SkCubeSat/radsat-v1/README.md

# radsat-v1
Repo for RADSAT-SK OBC flight board
