SkCubeSat/radsat-v1/kicad/oresat-c3.kicad_pcb

## KiCad design kicad/oresat-c3.kicad_pcb (continued)

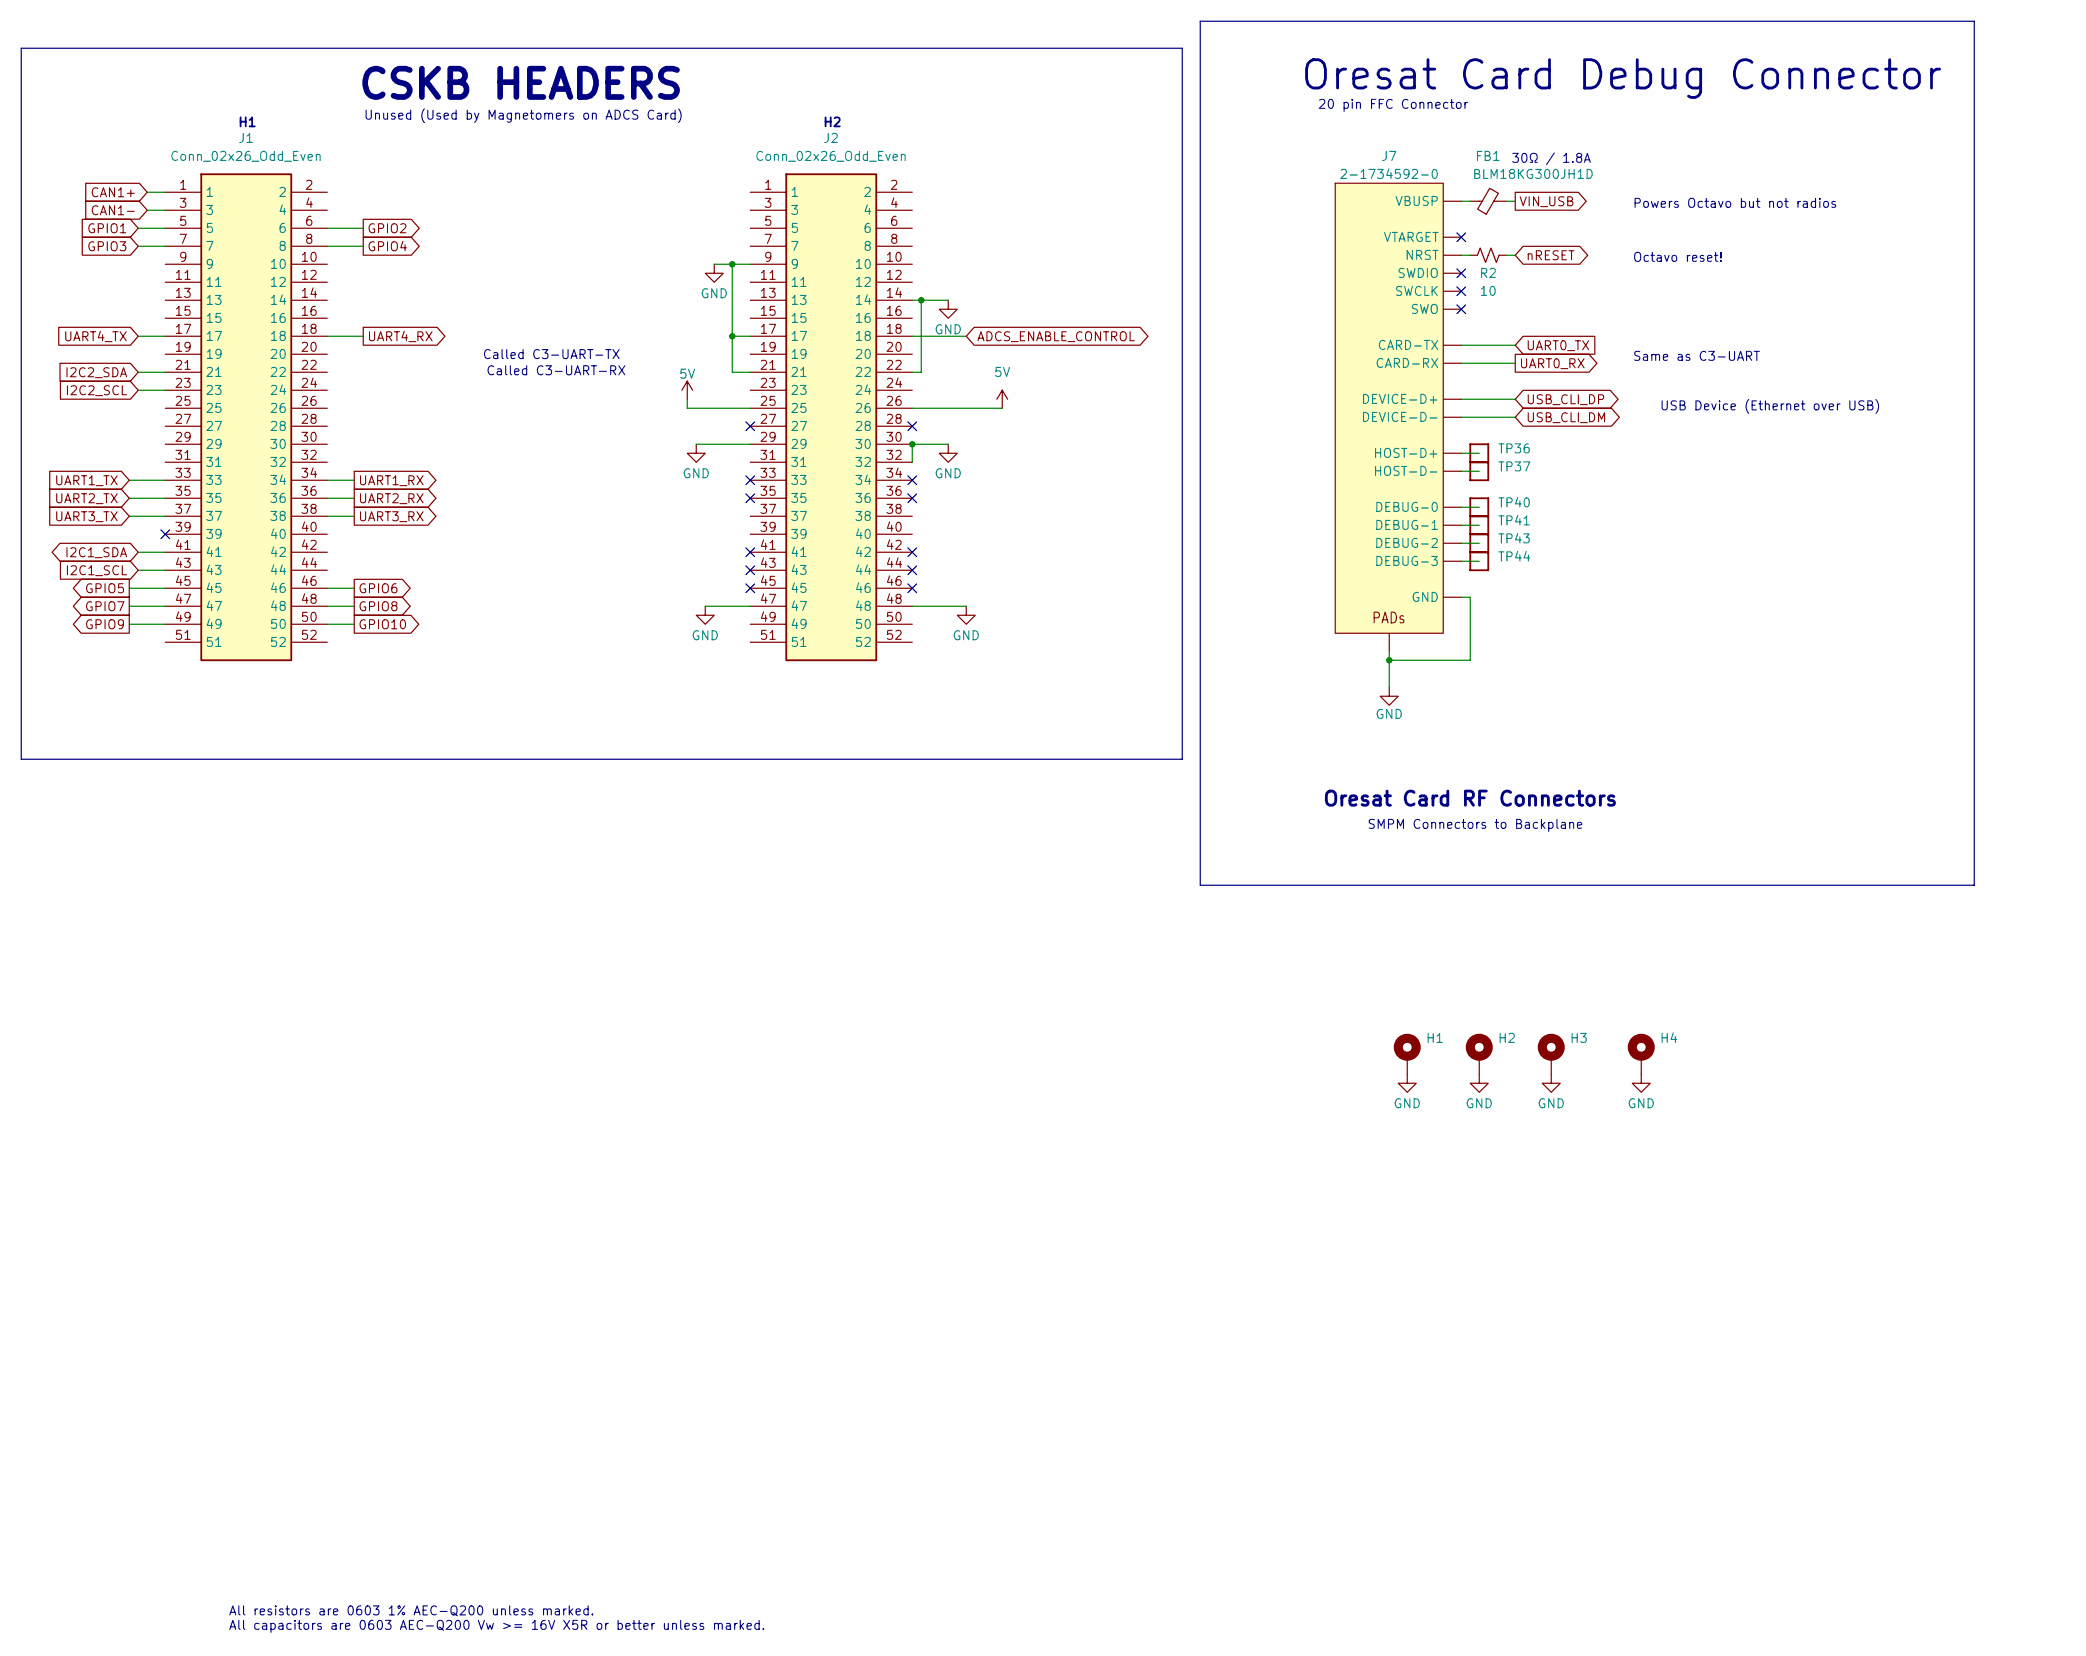
[picture p7: schematic oresat-c3-sch-connectors.kicad_sch, OreSat C3: Connectors]

Parts:
FB1: BLM18KG300JH1D; L_0603_1608Metric
H1, H2, H3, H4: MountingHole_Pad; MountingHole_3.2mm_M3_ISO7380_Pad
J1, J2: Conn_02x26_Odd_Even; RHDR52W64P254_2X26_6654X495X1135P; Manufacturer_Part_Number ESQ-126-39-G-D-001; Mouser Part Number 200-ESQ12639GD001
J7: 2-1734592-0; J-TE-2-1734592-0
R2: 10; R_0603_1608Metric
TP36, TP37, TP40, TP41, TP43, TP44: Test-Point; TestPoint_Pad_D1.0mm

Connections:
5V: J2.25, J2.26; also elsewhere on the board
ADCS_ENABLE_CONTROL: J2.18; also elsewhere on the board
CAN1+: J1.1; also elsewhere on the board
CAN1-: J1.3; also elsewhere on the board
GND: H1.1, H2.1, H3.1, H4.1, J2.9, J2.14, J2.17, J2.21, J2.22, J2.29, J2.30, J2.32, J2.47, J2.48, J7.3 (GND), J7.6 (GND), J7.9 (GND), J7.PAD1 (PAD), J7.PAD2 (PAD); also elsewhere on the board
GPIO1: J1.5
GPIO2: J1.6
GPIO3: J1.7
GPIO4: J1.8
GPIO5: J1.45
GPIO6: J1.46
GPIO7: J1.47
GPIO8: J1.48
GPIO9: J1.49
GPIO10: J1.50
I2C1_SCL: J1.43; also elsewhere on the board
I2C1_SDA: J1.41; also elsewhere on the board
I2C2_SCL: J1.23; also elsewhere on the board
I2C2_SDA: J1.21; also elsewhere on the board
unnamed: FB1.1, J7.1 (VBUSP), J7.2 (VBUSP)
unnamed: J7.17 (DEBUG-0), TP40.1
unnamed: J7.18 (DEBUG-1), TP41.1
unnamed: J7.19 (DEBUG-2), TP43.1
unnamed: J7.20 (DEBUG-3), TP44.1
unnamed: J7.7 (HOST-D+), TP36.1
unnamed: J7.8 (HOST-D-), TP37.1
unnamed: J7.10 (NRST), R2.1
UART0_RX: J7.12 (CARD-RX); also elsewhere on the board
UART0_TX: J7.13 (CARD-TX); also elsewhere on the board
UART1_RX: J1.34; also elsewhere on the board
UART1_TX: J1.33; also elsewhere on the board
UART2_RX: J1.36
UART2_TX: J1.35
UART3_RX: J1.38
UART3_TX: J1.37
UART4_RX: J1.18
UART4_TX: J1.17
USB_CLI_DM: J7.5 (DEVICE-D-); also elsewhere on the board
USB_CLI_DP: J7.4 (DEVICE-D+); also elsewhere on the board
VIN_USB: FB1.2; also elsewhere on the board
nRESET: R2.2; also elsewhere on the board

Notes on the sheet:
Powers Octavo but not radios
Called C3-UART-TX
Unused (Used by Magnetomers on ADCS Card)
USB Device (Ethernet over USB)
Oresat Card RF Connectors
Oresat Card Debug Connector
Called C3-UART-RX
Octavo reset!
CSKB HEADERS
SMPM Connectors to Backplane
30Ω / 1.8A
20 pin FFC Connector
Same as C3-UART
All resistors are 0603 1% AEC-Q200 unless marked. All capacitors are 0603 AEC-Q200 Vw >= 16V X5R or better unless marked.

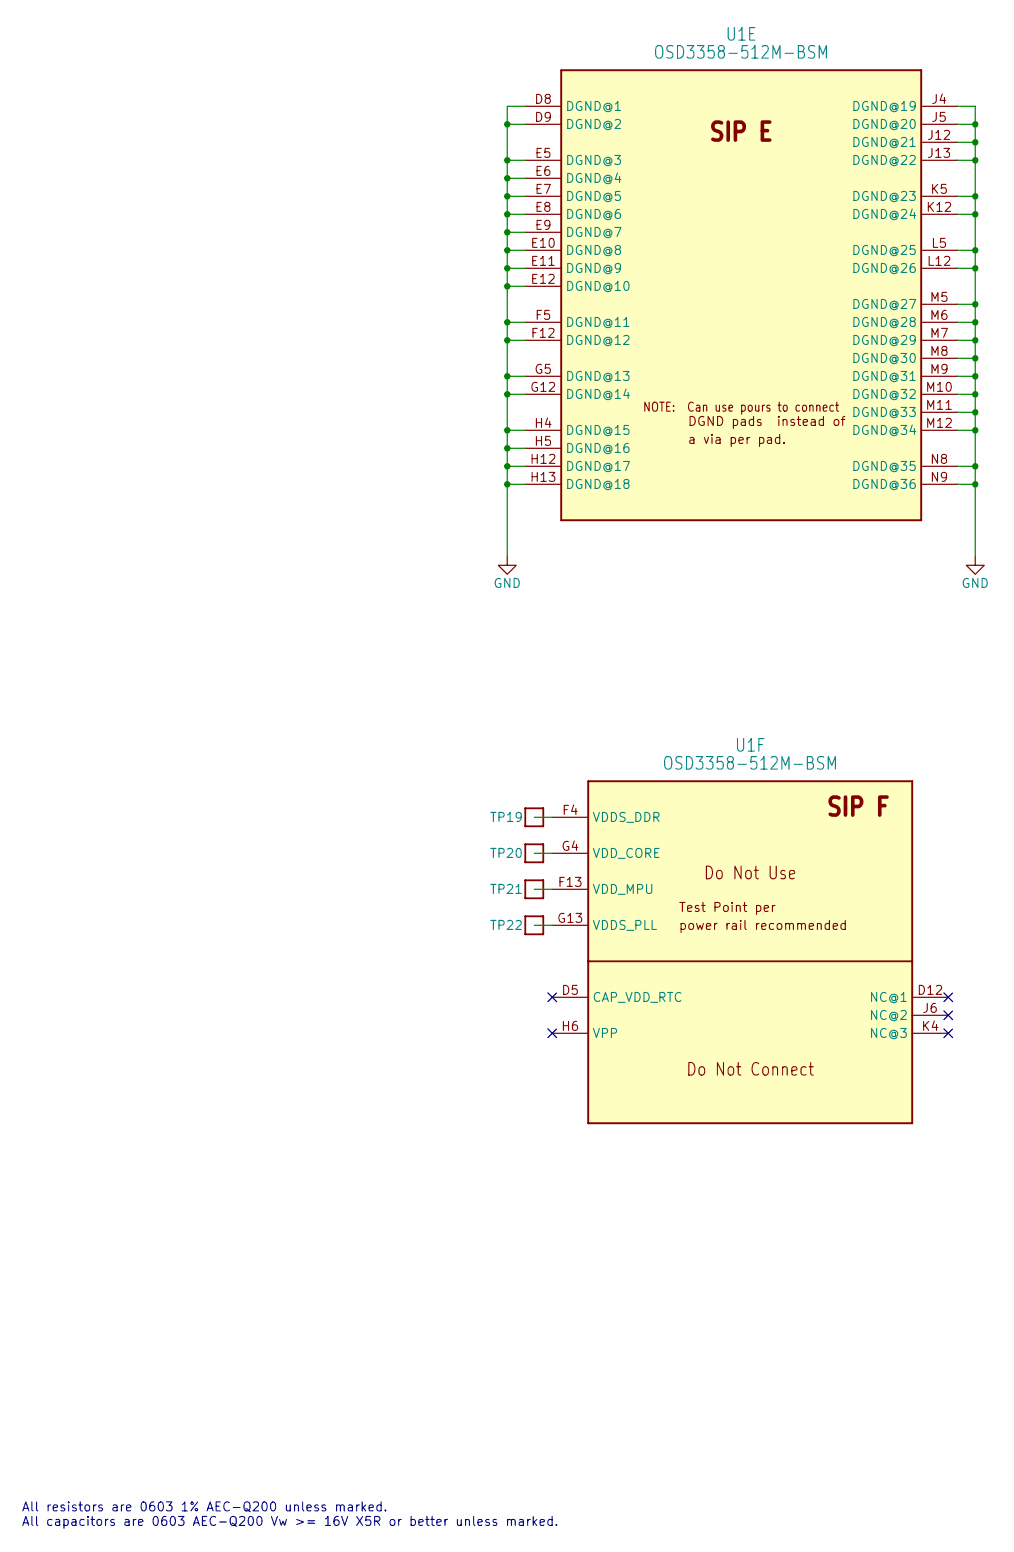
[picture p8: schematic oresat-c3-sch-osd3358-sip-e-f.kicad_sch, OreSat C3: OSD3358 SIP E + F]

Parts:
TP19, TP20, TP21, TP22: Test-Point; TestPoint_Pad_D1.0mm
U1: OSD3358-512M-BSM; U-Octavo-OSD335X-BGA-256; MPN OSD3358-512M-BSM

Connections:
GND: U1.D8 (DGND@1), U1.D9 (DGND@2), U1.E5 (DGND@3), U1.E6 (DGND@4), U1.E7 (DGND@5), U1.E8 (DGND@6), U1.E9 (DGND@7), U1.E10 (DGND@8), U1.E11 (DGND@9), U1.E12 (DGND@10), U1.F5 (DGND@11), U1.F12 (DGND@12), U1.G5 (DGND@13), U1.G12 (DGND@14), U1.H4 (DGND@15), U1.H5 (DGND@16), U1.H12 (DGND@17), U1.H13 (DGND@18), U1.J4 (DGND@19), U1.J5 (DGND@20), U1.J12 (DGND@21), U1.J13 (DGND@22), U1.K5 (DGND@23), U1.K12 (DGND@24), U1.L5 (DGND@25), U1.L12 (DGND@26), U1.M5 (DGND@27), U1.M6 (DGND@28), U1.M7 (DGND@29), U1.M8 (DGND@30), U1.M9 (DGND@31), U1.M10 (DGND@32), U1.M11 (DGND@33), U1.M12 (DGND@34), U1.N8 (DGND@35), U1.N9 (DGND@36); also elsewhere on the board
unnamed: TP19.1, U1.F4 (VDDS_DDR)
unnamed: TP22.1, U1.G13 (VDDS_PLL)
unnamed: TP20.1, U1.G4 (VDD_CORE)
unnamed: TP21.1, U1.F13 (VDD_MPU)

Notes on the sheet:
All resistors are 0603 1% AEC-Q200 unless marked. All capacitors are 0603 AEC-Q200 Vw >= 16V X5R or better unless marked.

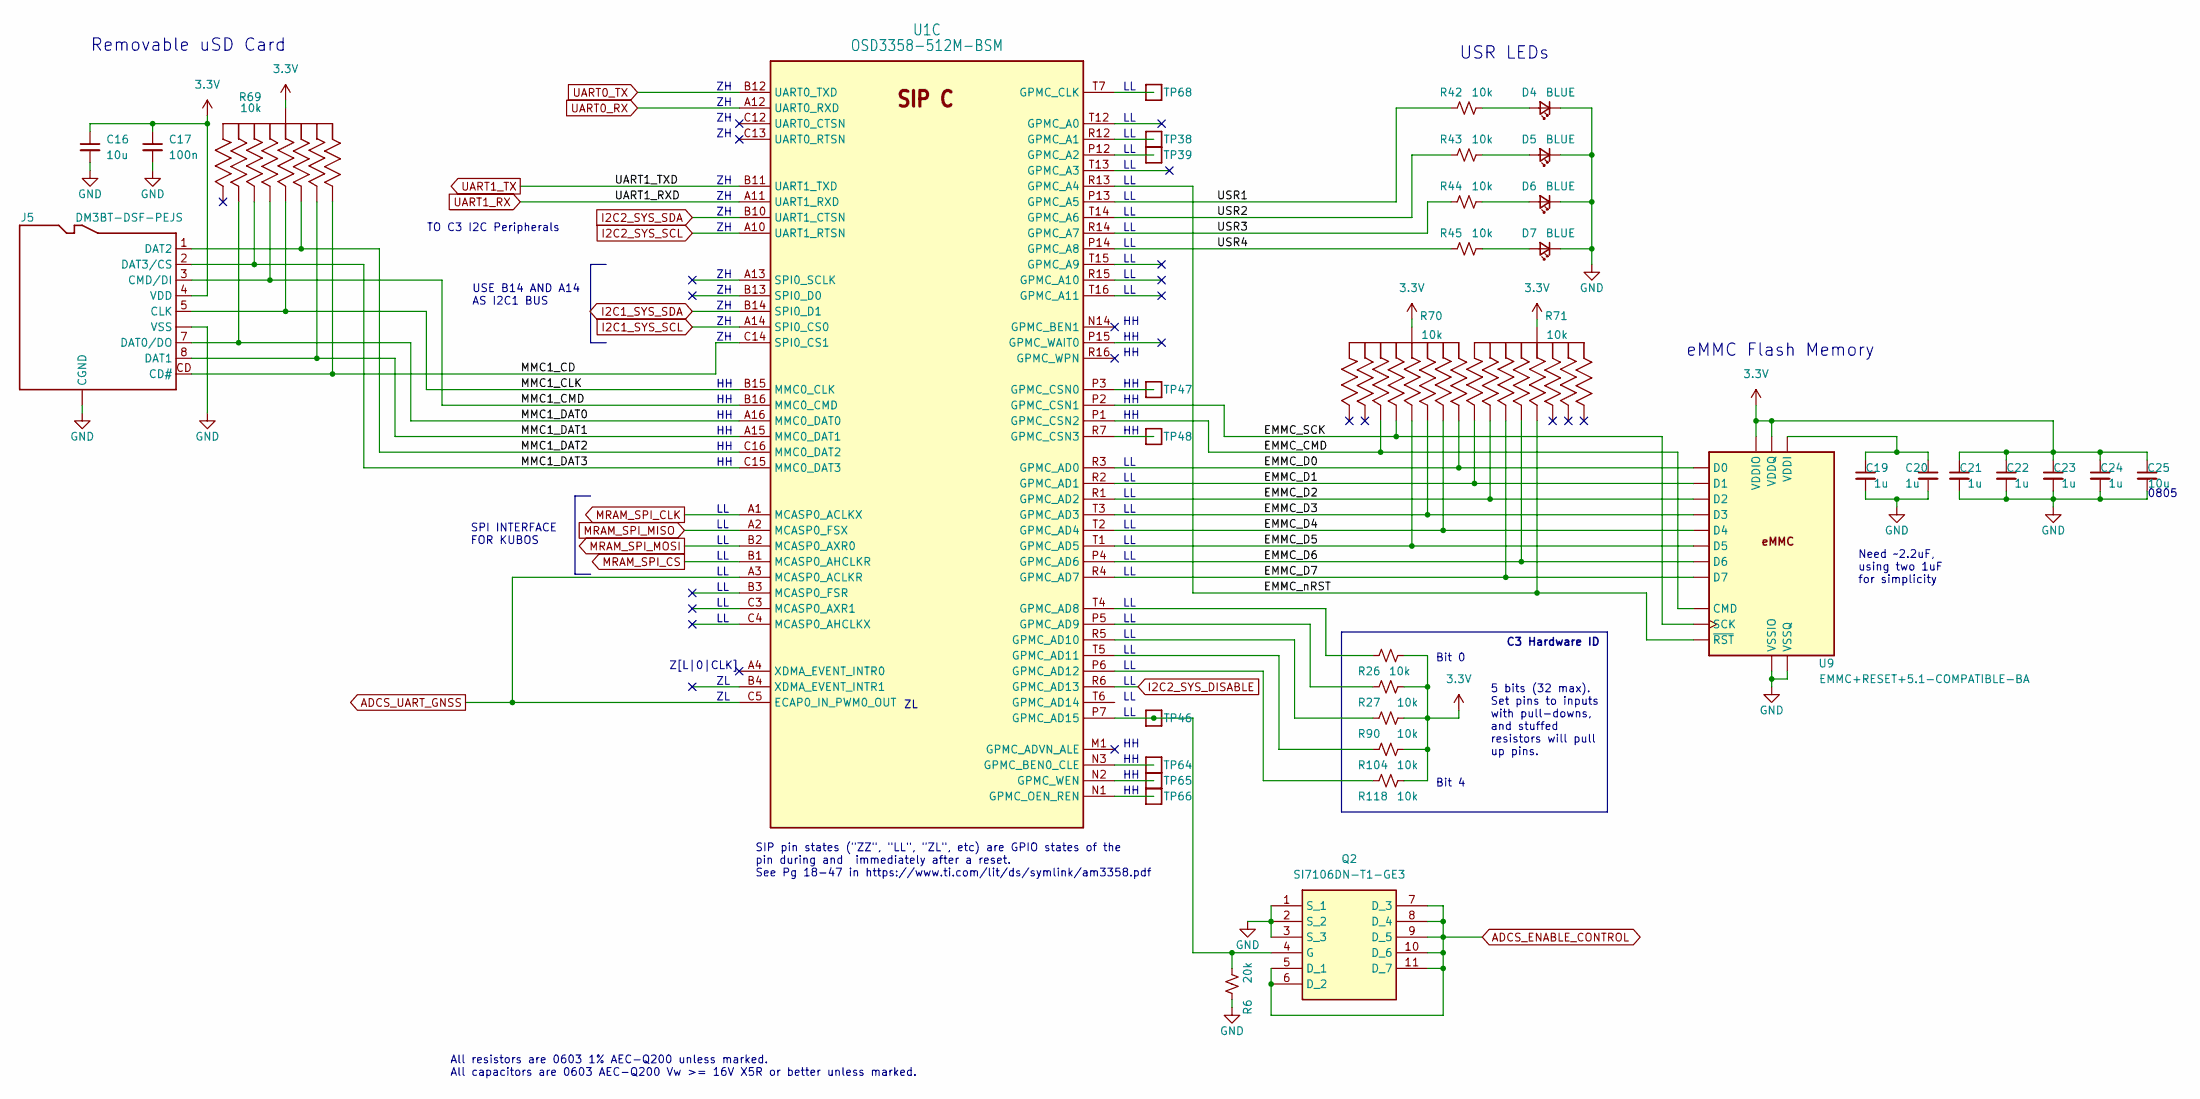
[picture p9: schematic oresat-c3-sch-osd3358-sd-emmc.kicad_sch, OreSat C3: OSD3358 SIP C]

Parts:
C16, C25: 10u; C_0805_2012Metric
C17: 100n; C_0603_1608Metric
C19, C20, C21, C22, C23, C24: 1u; C_0603_1608Metric
D4, D5, D6, D7: BLUE; LED_0603_1608Metric
J5: DM3BT-DSF-PEJS; J-Hirose-DM3BT-DSF-PEJS
Q2: SI7106DN-T1-GE3; SIS862DNT1GE3; Mouser Part Number 781-SI7106DN-T1-GE3
R6: 20k; R_0603_1608Metric
R26, R27, R42, R43, R44, R45, R90, R104, R118: 10k; R_0603_1608Metric
R69, R70, R71: 10k; Panasonic_Resistor_Array_EXBA10
TP38, TP39, TP46, TP47, TP48, TP64, TP65, TP66, TP68: Test-Point; TestPoint_Pad_D1.0mm
U1: OSD3358-512M-BSM; U-Octavo-OSD335X-BGA-256; MPN OSD3358-512M-BSM
U9: EMMC+RESET+5.1-COMPATIBLE-BA; BGA-153(11.5X13)(EMMC-BA)

Connections:
3.3V: C16.1, C17.1, C21.1, C22.1, C23.1, C24.1, C25.1, J5.4 (VDD), R26.1, R27.1, R69.5 (55), R69.10 (55), R70.5 (55), R70.10 (55), R71.5 (55), R71.10 (55), R90.1, R104.1, R118.1, U9.C6 (VDDQ), U9.E6 (VDDIO), U9.F5 (VDDIO), U9.J10 (VDDIO), U9.K9 (VDDIO), U9.M4 (VDDQ), U9.N4 (VDDQ), U9.P3 (VDDQ), U9.P5 (VDDQ); also elsewhere on the board
/OSD3358: SIP C/EMMC_CMD: R70.2 (22), U1.P1 (GPMC_CSN2), U9.M5 (CMD)
/OSD3358: SIP C/EMMC_D0: R70.6 (66), U1.R3 (GPMC_AD0), U9.A3 (D0)
/OSD3358: SIP C/EMMC_D1: R71.1 (11), U1.R2 (GPMC_AD1), U9.A4 (D1)
/OSD3358: SIP C/EMMC_D2: R71.9 (99), U1.R1 (GPMC_AD2), U9.A5 (D2)
/OSD3358: SIP C/EMMC_D3: R70.7 (77), U1.T3 (GPMC_AD3), U9.B2 (D3)
/OSD3358: SIP C/EMMC_D4: R70.4 (44), U1.T2 (GPMC_AD4), U9.B3 (D4)
/OSD3358: SIP C/EMMC_D5: R70.3 (33), U1.T1 (GPMC_AD5), U9.B4 (D5)
/OSD3358: SIP C/EMMC_D6: R71.8 (88), U1.P4 (GPMC_AD6), U9.B5 (D6)
/OSD3358: SIP C/EMMC_D7: R71.2 (22), U1.R4 (GPMC_AD7), U9.B6 (D7)
/OSD3358: SIP C/EMMC_SCK: R70.8 (88), U1.P2 (GPMC_CSN1), U9.M6 (SCK)
/OSD3358: SIP C/EMMC_nRST: R71.3 (33), U1.R13 (GPMC_A4), U9.K5 (~RST)
/OSD3358: SIP C/MMC1_CD: J5.CD (CD#), R69.6 (66), U1.C14 (SPI0_CS1)
/OSD3358: SIP C/MMC1_CLK: J5.5 (CLK), R69.3 (33), U1.B15 (MMC0_CLK)
/OSD3358: SIP C/MMC1_CMD: J5.3 (CMD/DI), R69.8 (88), U1.B16 (MMC0_CMD)
/OSD3358: SIP C/MMC1_DAT0: J5.7 (DAT0/DO), R69.9 (99), U1.A16 (MMC0_DAT0)
/OSD3358: SIP C/MMC1_DAT1: J5.8 (DAT1), R69.4 (44), U1.A15 (MMC0_DAT1)
/OSD3358: SIP C/MMC1_DAT2: J5.1 (DAT2), R69.7 (77), U1.C16 (MMC0_DAT2)
/OSD3358: SIP C/MMC1_DAT3: J5.2 (DAT3/CS), R69.2 (22), U1.C15 (MMC0_DAT3)
/OSD3358: SIP C/USR1: R42.1, U1.P13 (GPMC_A5)
/OSD3358: SIP C/USR2: R43.1, U1.T14 (GPMC_A6)
/OSD3358: SIP C/USR3: R44.1, U1.R14 (GPMC_A7)
/OSD3358: SIP C/USR4: R45.1, U1.P14 (GPMC_A8)
ADCS_ENABLE_CONTROL: Q2.5 (D_1), Q2.6 (D_2), Q2.7 (D_3), Q2.8 (D_4), Q2.9 (D_5), Q2.10 (D_6), Q2.11 (D_7); also elsewhere on the board
ADCS_UART_GNSS: U1.A3 (MCASP0_ACLKR), U1.C5 (ECAP0_IN_PWM0_OUT)
GND: C16.2, C17.2, C19.2, C20.2, C21.2, C22.2, C23.2, C24.2, C25.2, D4.1 (K), D5.1 (K), D6.1 (K), D7.1 (K), J5.6 (VSS), J5.CGND1 (CGND), J5.CGND2 (CGND), J5.CGND3 (CGND), J5.CGND4 (CGND), J5.CGND5 (CGND), J5.CGND6 (CGND), J5.GND (VSS), Q2.1 (S_1), Q2.2 (S_2), Q2.3 (S_3), R6.2, U9.A2 (NC), U9.A6 (VSSIO), U9.B7 (NC), U9.C4 (VSSQ), U9.E7 (VSSIO), U9.G5 (VSSIO), U9.H10 (VSSIO), U9.J5 (VSSIO), U9.K8 (VSSIO), U9.N2 (VSSQ), U9.N5 (VSSQ), U9.P4 (VSSQ), U9.P6 (VSSQ); also elsewhere on the board
I2C1_SYS_SCL: U1.A14 (SPI0_CS0); also elsewhere on the board
I2C1_SYS_SDA: U1.B14 (SPI0_D1); also elsewhere on the board
I2C2_SYS_DISABLE: U1.R6 (GPMC_AD13); also elsewhere on the board
I2C2_SYS_SCL: U1.A10 (UART1_RTSN); also elsewhere on the board
I2C2_SYS_SDA: U1.B10 (UART1_CTSN); also elsewhere on the board
MRAM_SPI_CLK: U1.A1 (MCASP0_ACLKX); also elsewhere on the board
MRAM_SPI_CS: U1.B1 (MCASP0_AHCLKR); also elsewhere on the board
MRAM_SPI_MISO: U1.A2 (MCASP0_FSX); also elsewhere on the board
MRAM_SPI_MOSI: U1.B2 (MCASP0_AXR0); also elsewhere on the board
unnamed: D4.2 (A), R42.2
unnamed: D5.2 (A), R43.2
unnamed: D6.2 (A), R44.2
unnamed: D7.2 (A), R45.2
unnamed: Q2.4 (G), R6.1, TP46.1, U1.P7 (GPMC_AD15)
unnamed: TP38.1, U1.R12 (GPMC_A1)
unnamed: TP39.1, U1.P12 (GPMC_A2)
unnamed: R26.2, U1.T4 (GPMC_AD8)
unnamed: R27.2, U1.P5 (GPMC_AD9)
unnamed: R90.2, U1.R5 (GPMC_AD10)
unnamed: R104.2, U1.T5 (GPMC_AD11)
unnamed: R118.2, U1.P6 (GPMC_AD12)
unnamed: TP64.1, U1.N3 (GPMC_BEN0_CLE)
unnamed: TP68.1, U1.T7 (GPMC_CLK)
unnamed: TP47.1, U1.P3 (GPMC_CSN0)
unnamed: TP48.1, U1.R7 (GPMC_CSN3)
unnamed: TP66.1, U1.N1 (GPMC_OEN_REN)
unnamed: TP65.1, U1.N2 (GPMC_WEN)
unnamed: C19.1, C20.1, U9.C2 (VDDI)
UART0_RX: U1.A12 (UART0_RXD); also elsewhere on the board
UART0_TX: U1.B12 (UART0_TXD); also elsewhere on the board
UART1_RX: U1.A11 (UART1_RXD); also elsewhere on the board
UART1_TX: U1.B11 (UART1_TXD); also elsewhere on the board

Notes on the sheet:
0805
5 bits (32 max). Set pins to inputs with pull-downs, and stuffed resistors will pull up pins.
eMMC Flash Memory
SPI INTERFACE FOR KUBOS
Removable uSD Card
C3 Hardware ID
Need ~2.2uF, using two 1uF for simplicity
Bit 0
SIP pin states ("ZZ", "LL", "ZL", etc) are GPIO states of the pin during and immediately after a reset. See Pg 18-47 in https://www.ti.com/lit/ds/symlink/am3358.pdf
USR LEDs
Z[L|0|CLK]
Bit 4
TO C3 I2C Peripherals
All resistors are 0603 1% AEC-Q200 unless marked. All capacitors are 0603 AEC-Q200 Vw >= 16V X5R or better unless marked.
USE B14 AND A14 AS I2C1 BUS

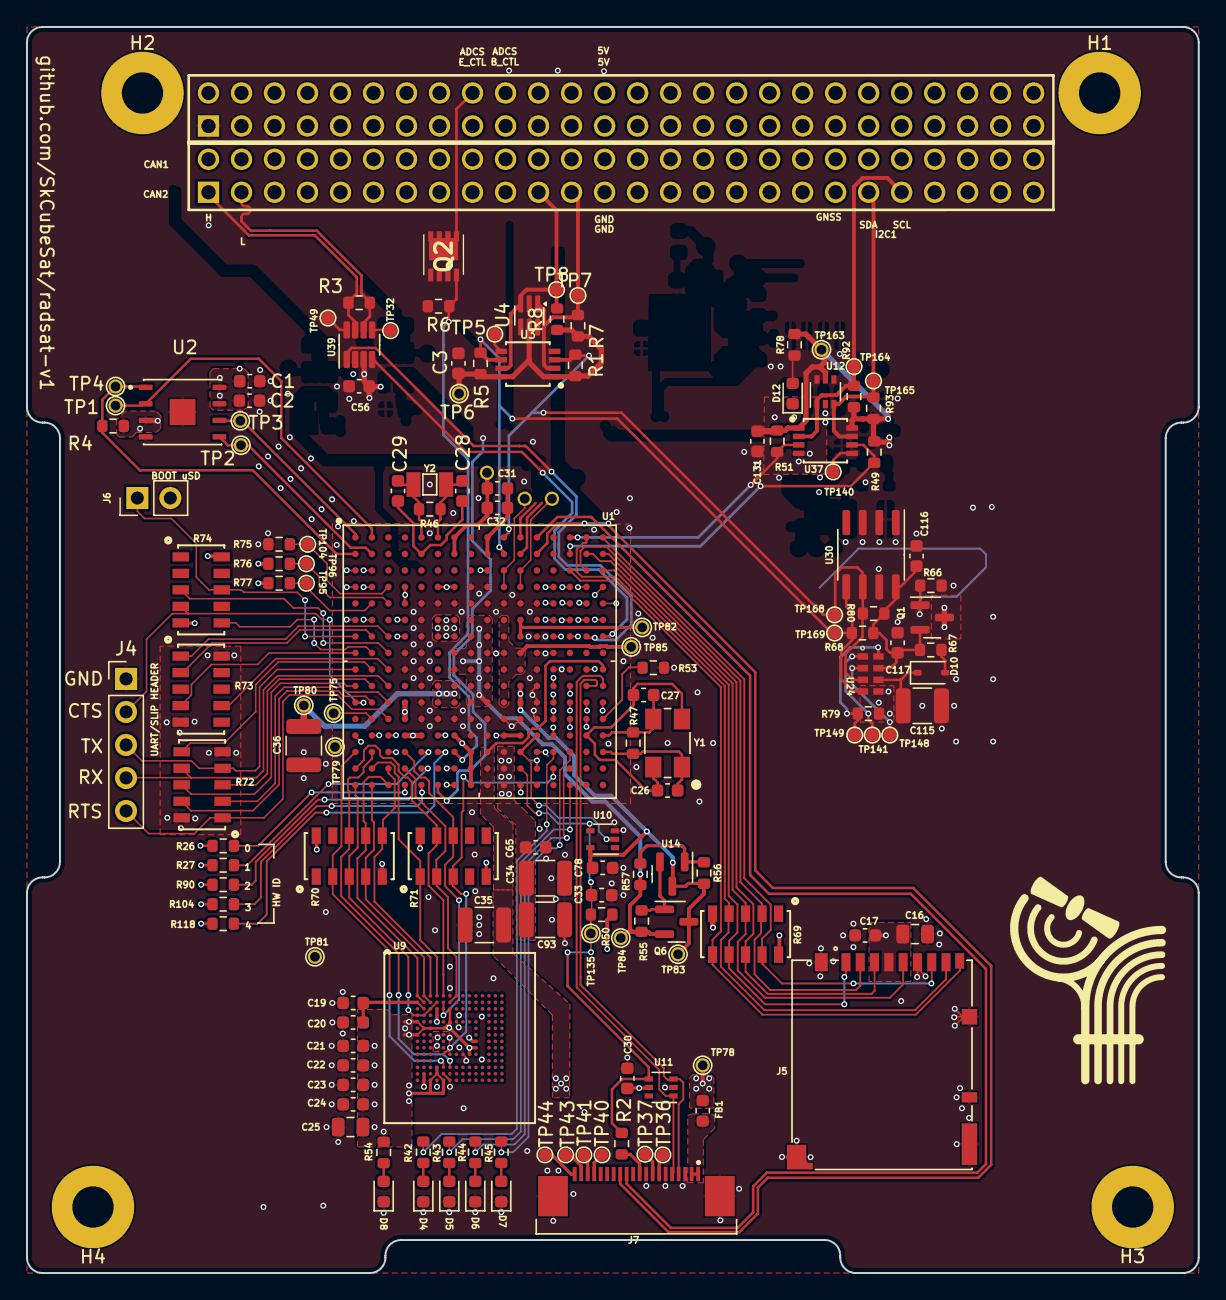
[picture p10: board oresat-c3.kicad_pcb from above]

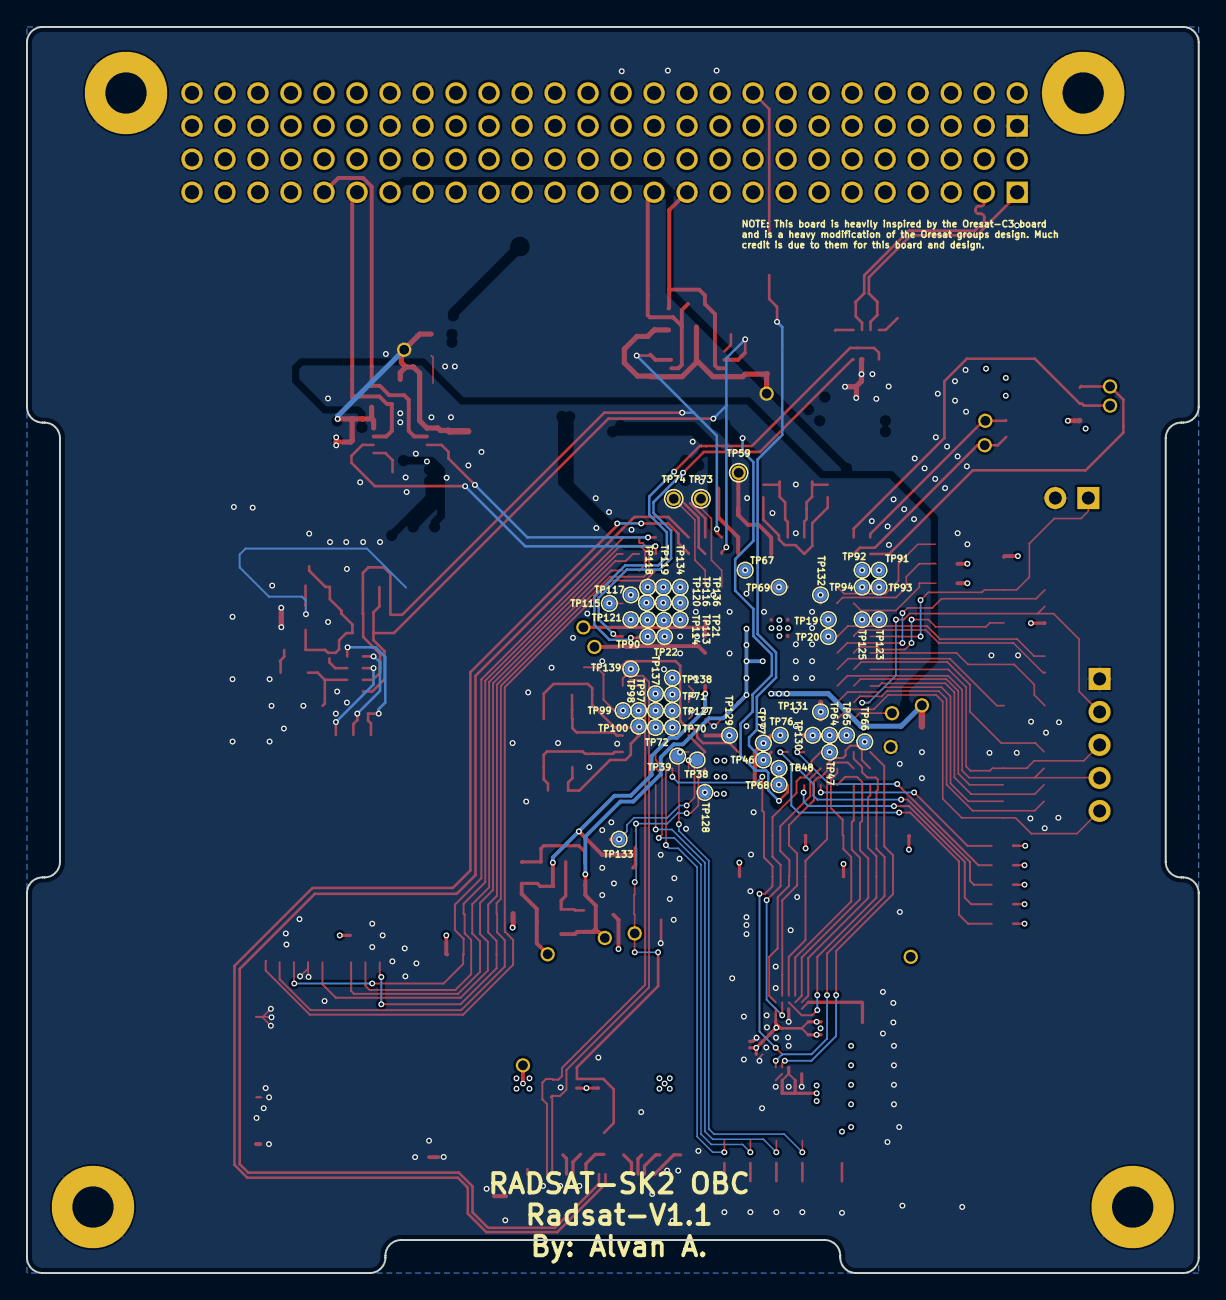
[picture p11: board oresat-c3.kicad_pcb from below]

Board: 4 copper layers, 90.2 x 95.9 mm, 204 parts (55 on the bottom side), 172 nets.

Other parts of the board:
C3: 10n; C_0603_1608Metric
R1, R5, R7, R8: 10k; R_0603_1608Metric
TP5: TestPoint_Pad_D1.0mm
TP6: TestPoint-MinTH; TestPoint-0.75mm-th
TP7, TP8: Test-Point; TestPoint_Pad_D1.0mm
U3: LTC4300A-1; LINEAR-MSOP-8-AND-MAXIM-UMAX-8-21-0036
U4: RCLAMP0504FB; SOT-363_SC-70-6

Their connections:
3.3V: C3.1, R1.1, R5.1, R7.1, R8.1, TP6.1, U3.1 (ENABLE), U3.8 (VCC), U4.5 (VCC); also elsewhere on the board
GND: C3.2, U3.4 (GND), U4.2 (GND); also elsewhere on the board
I2C2_SCL: R7.2, TP7.1, U3.2 (SCLOUT), U4.1 (I1); also elsewhere on the board
I2C2_SDA: R8.2, TP8.1, U3.7 (SDAOUT), U4.3 (I2); also elsewhere on the board
I2C2_SYS_SCL: R1.2, U3.3 (SCLIN); also elsewhere on the board
I2C2_SYS_SDA: R5.2, U3.6 (SDAIN); also elsewhere on the board
unnamed: TP5.1, U3.5 (READY)
