SkCubeSat/radsat-v1/(commit log)

2024-02-16 Initial commit with oresat OBC kicad files
    [oresat-c3-sch-connectors.kicad_sch, oresat-c3-sch-deployers.kicad_sch, oresat-c3-sch-i2c-peripherals.kicad_sch, oresat-c3-sch-l-band.kicad_sch, oresat-c3-sch-opd-and-i2c.kicad_sch, oresat-c3-sch-osd3358-power.kicad_sch, oresat-c3-sch-osd3358-sd-emmc.kicad_sch, oresat-c3-sch-osd3358-sip-e-f.kicad_sch]
2024-02-19 Added Oresat symbol lib. Removed any L-band related components from pcb and schematic
    [J-Amphenol-132134-10-SMA-F-SMT-vertical.stp, J-Harwin-M80-5100442.stp, J-Molex-547220304.stp, J-Molex-555600307.stp, J-Molex-SMPM-733000020.stp, J-SAMTEC-TFM-110-01-L-D-RA.stp, J-SAMTEC-TFM-120-01-L-D-RA.stp, J-TE-2-1734592-0-c-3d.stp]
2024-02-19 Removed UF band
    [oresat-c3-sch-connectors.kicad_sch, oresat-c3-sch-osd3358-sd-emmc.kicad_sch, oresat-c3-sch-osd3358-usb-xtal.kicad_sch, oresat-c3-sch-power.kicad_sch, oresat-c3-sch-uhf-band.kicad_sch]
2024-02-20 Removed power switching circuitry
    [oresat-c3-sch-osd3358-power.kicad_sch, oresat-c3-sch-osd3358-sd-emmc.kicad_sch, oresat-c3-sch-osd3358-sysboot.kicad_sch, oresat-c3-sch-osd3358-usb-xtal.kicad_sch, oresat-c3-sch-power.kicad_sch]
2024-02-20 Removed antenna deployers
2024-02-20 Removed antenna deployers, fixed
    [oresat-c3-sch-connectors.kicad_sch, oresat-c3-sch-deployers.kicad_sch, oresat-c3-sch-opd-and-i2c.kicad_sch, oresat-c3-sch-osd3358-power.kicad_sch, oresat-c3-sch-osd3358-sd-emmc.kicad_sch, oresat-c3-sch-osd3358-sip-e-f.kicad_sch, oresat-c3-sch-osd3358-sysboot.kicad_sch, oresat-c3-sch-osd3358-usb-xtal.kicad_sch]
2024-02-20 Finished removing components and rerouting. Still need to place voltage and GND planes
    [oresat-c3-sch-connectors.kicad_sch, oresat-c3-sch-osd3358-sd-emmc.kicad_sch, oresat-c3-sch-osd3358-sysboot.kicad_sch, oresat-c3.kicad_sch]
2024-02-24 Added Power and ground planes, still need to fix a few things
    [oresat-c3-sch-connectors.kicad_sch, oresat-c3.kicad_pcb]
2024-02-24 Fixed power plane issues
    [oresat-c3-sch-connectors.kicad_sch, oresat-c3-sch-osd3358-power.kicad_sch, oresat-c3-sch-watchdog.kicad_sch, oresat-c3.kicad_pcb]
2024-02-25 Fixed most DRC checks
    [oresat-c3-sch-osd3358-power.kicad_sch]
2024-02-25 Fixed some issues, still need to clear DRC
    [oresat-c3-sch-osd3358-power.kicad_sch, oresat-c3-sch-osd3358-sd-emmc.kicad_sch, oresat-c3-sch-osd3358-sysboot.kicad_sch, oresat-c3-sch-watchdog.kicad_sch]
2024-03-09 Added GND fences to traces
2024-03-15 created BOM and gerber
    [oresat-c3-B_Cu.gbl, oresat-c3-B_Mask.gbs, oresat-c3-B_Paste.gbp, oresat-c3-B_Silkscreen.gbo, oresat-c3-Edge_Cuts.gm1, oresat-c3-F_Cu.gtl, oresat-c3-F_Mask.gts, oresat-c3-F_Paste.gtp]
2024-03-15 Credited oresat
    [oresat-c3-B_Cu.gbl, oresat-c3-B_Mask.gbs, oresat-c3-B_Paste.gbp, oresat-c3-B_Silkscreen.gbo, oresat-c3-Edge_Cuts.gm1, oresat-c3-F_Cu.gtl, oresat-c3-F_Mask.gts, oresat-c3-F_Paste.gtp]
2024-10-03 Created BOM for ordering
2024-10-03 Increased trace width on 5V AC_Input
2024-10-04 Fixed FFC connector orientation
2024-10-15 Switched 3.3V generation from CSKB to OSD3358
    [oresat-c3-B_Cu.gbl, oresat-c3-B_Mask.gbs, oresat-c3-B_Paste.gbp, oresat-c3-B_Silkscreen.gbo, oresat-c3-Edge_Cuts.gm1, oresat-c3-F_Cu.gtl, oresat-c3-F_Mask.gts, oresat-c3-F_Paste.gtp]
2024-10-17 Added mounting holes
    [oresat-c3-sch-connectors.kicad_sch, oresat-c3-sch-osd3358-sd-emmc.kicad_sch]
2024-10-17 Modified CSKB pinout to correct format, also made sure it is PC104 standard
    [oresat-c3-sch-connectors.kicad_sch, oresat-c3-sch-osd3358-sd-emmc.kicad_sch]
2024-10-30 Redid 3v3 power scheme
    [oresat-c3-sch-connectors.kicad_sch, oresat-c3-sch-opd-and-i2c.kicad_sch, oresat-c3-sch-osd3358-power.kicad_sch, oresat-c3-sch-osd3358-sd-emmc.kicad_sch, oresat-c3-sch-osd3358-sip-e-f.kicad_sch, oresat-c3-sch-osd3358-sysboot.kicad_sch, oresat-c3-sch-osd3358-usb-xtal.kicad_sch, oresat-c3-sch-watchdog.kicad_sch]
2024-10-31 Added I2C1 bus lines
    [oresat-c3-sch-connectors.kicad_sch, oresat-c3-sch-osd3358-sd-emmc.kicad_sch]
2024-11-04 Fixed silkscreen labels
2024-11-07 Removed OPD and added LTC4300A to I2C1 bus
    [oresat-c3-sch-connectors.kicad_sch, oresat-c3-sch-opd-and-i2c.kicad_sch, oresat-c3-sch-osd3358-sd-emmc.kicad_sch, oresat-c3.kicad_pcb]
2024-11-07 Added CAN bus termination resistors
    [oresat-c3-sch-osd3358-sd-emmc.kicad_sch, oresat-c3-sch-osd3358-sysboot.kicad_sch, oresat-c3-sch-osd3358-usb-xtal.kicad_sch, oresat-c3.kicad_pcb]
2024-11-08 Added GPIO enable pins for ADCS
    [oresat-c3-sch-connectors.kicad_sch, oresat-c3-sch-osd3358-sd-emmc.kicad_sch, oresat-c3.kicad_pcb]
2024-11-08 Switched 5V on AC_Input to a plane instead of traces
    [oresat-c3.kicad_pcb]
2024-11-09 Brought out some pins that need to be used for UART SLIP connection on sysboot schematic
    [oresat-c3-sch-osd3358-sysboot.kicad_sch, oresat-c3.kicad_pcb]
2024-11-09 Added via stitching
    [oresat-c3.kicad_pcb]
2024-11-12 Added UART TX pin for ADCS GNSS. Also fixed I2C SDA/SCL, they were swapped accidently
    [oresat-c3-sch-connectors.kicad_sch, oresat-c3-sch-osd3358-sd-emmc.kicad_sch, oresat-c3.kicad_pcb]
2025-01-27 pcb changes
    [oresat-c3.kicad_pcb]
2025-01-29 Removed floating metal pours with via filling
    [oresat-c3.kicad_pcb]
2025-01-30 Removed watchdog
    [oresat-c3-sch-connectors.kicad_sch, oresat-c3.kicad_pcb, oresat-c3.kicad_sch]
2025-01-30 Reworked 3v3 pour on In2 Layer
    [oresat-c3.kicad_pcb]
2025-02-04 Added MRAM chip to board
    [mram-and-spi.kicad_sch, oresat-c3-sch-osd3358-sd-emmc.kicad_sch, oresat-c3.kicad_pcb, oresat-c3.kicad_sch]
2025-02-06 Added extra decoupling capacitor to MRAM. Also grounded all unused pins and mounting holes
    [mram-and-spi.kicad_sch, oresat-c3-sch-connectors.kicad_sch, oresat-c3-sch-osd3358-sd-emmc.kicad_sch, oresat-c3-sch-osd3358-usb-xtal.kicad_sch, oresat-c3.kicad_pcb]
2025-02-10 Re-orientated silkscreen and added more via fencing. Also fixed BOM
    [oresat-c3-B_Cu.gbl, oresat-c3-B_Mask.gbs, oresat-c3-B_Paste.gbp, oresat-c3-B_Silkscreen.gbo, oresat-c3-Edge_Cuts.gm1, oresat-c3-F_Cu.gtl, oresat-c3-F_Mask.gts, oresat-c3-F_Paste.gtp]
2025-02-12 Fixed skew on CAN lines
    [oresat-c3-sch-connectors.kicad_sch, oresat-c3-sch-osd3358-sd-emmc.kicad_sch, oresat-c3-sch-osd3358-sysboot.kicad_sch, oresat-c3.kicad_pcb]
2025-02-13 Added CTS and RTS pin to UART header. Re-arranged silkscreens. Added Silkscreen labels to CSKB. Added fencing on I2C lines
    [oresat-c3-sch-osd3358-sysboot.kicad_sch, oresat-c3.kicad_pcb]
2025-02-13 Fixed ADCS Labels
    [oresat-c3.kicad_pcb]
2025-02-19 Created BOM
    [oresat-c3.kicad_pcb, radsat-v1-rev2-BOM.kicad_pcb.xls]
2026-01-07 Prep for PC104 Update
    [oresat-c3.kicad_pcb]
2026-01-11 Updated PCB to the new PC104 template form factor
    [oresat-c3.kicad_pcb]
2026-01-11 Resolved library conflicts and added 3D models
    [mram-and-spi.kicad_sch, oresat-c3-sch-connectors.kicad_sch, oresat-c3-sch-opd-and-i2c.kicad_sch, oresat-c3-sch-osd3358-power.kicad_sch, oresat-c3-sch-osd3358-sd-emmc.kicad_sch, oresat-c3-sch-osd3358-sip-e-f.kicad_sch, oresat-c3-sch-osd3358-sysboot.kicad_sch, oresat-c3-sch-osd3358-usb-xtal.kicad_sch]
2026-01-18 Updated PC104 connector with current version
    [oresat-c3-sch-connectors.kicad_sch, oresat-c3.kicad_pcb]
2026-01-22 - Locked CSKB Headers on PCB - Removed CAN1 from schematic - Removed ADCS boot enable from schematic - Removed unnecessary grounds from PCB
    [oresat-c3-sch-connectors.kicad_sch, oresat-c3-sch-osd3358-sd-emmc.kicad_sch, oresat-c3.kicad_pcb]
2026-01-22 forgot to save pcb for previous commit
    [oresat-c3.kicad_pcb]
2026-01-29 Finished Labelling CSKB - Removed old UART GNSS Pin, no longer needed - Labelled GPIOs on CSKB - Mapped all available GPIOs in BBB Sheet - Labelled UART lines on CSKB
    [oresat-c3-sch-connectors.kicad_sch, oresat-c3-sch-opd-and-i2c.kicad_sch, oresat-c3.kicad_pcb]
2026-01-31 - Grounded FRAM Write protect permanently - Erased old CAN transceivers for unused bus - Fixed CAN termination resistor value to 120 ohm - Redid Clock skew for CAN lines - Removed UART0 from CSKB - A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
    [oresat-c3-sch-connectors.kicad_sch, oresat-c3-sch-opd-and-i2c.kicad_sch, oresat-c3-sch-osd3358-sd-emmc.kicad_sch, oresat-c3-sch-osd3358-sysboot.kicad_sch, oresat-c3.kicad_pcb]
2026-01-31 - Labelled GPIOs and UART lines to processor pins - Routed UART lines - Routed GPIO Lines - Refilled zones - Added via fencing back in - Board should be ready to be reviewed now
    [oresat-c3-sch-connectors.kicad_sch, oresat-c3-sch-osd3358-sd-emmc.kicad_sch, oresat-c3-sch-osd3358-sysboot.kicad_sch]
2026-02-01 OBC review session changes
    [oresat-c3-sch-osd3358-sd-emmc.kicad_sch]
2026-02-04 Added 2 new GPIO pins
    [oresat-c3-sch-connectors.kicad_sch, oresat-c3-sch-osd3358-sd-emmc.kicad_sch]
2026-02-04 - Configured pin headers for UART5 and boot pins to be horizontal - Removed some TPs for GPIO pins
    [oresat-c3-sch-osd3358-sd-emmc.kicad_sch, oresat-c3-sch-osd3358-sysboot.kicad_sch]
2026-02-05 Moved connectors around, still needs to be routed
    [mram-and-spi.kicad_sch, oresat-c3-sch-connectors.kicad_sch, oresat-c3-sch-opd-and-i2c.kicad_sch, oresat-c3-sch-osd3358-power.kicad_sch, oresat-c3-sch-osd3358-sd-emmc.kicad_sch, oresat-c3-sch-osd3358-sip-e-f.kicad_sch, oresat-c3-sch-osd3358-sysboot.kicad_sch, oresat-c3-sch-osd3358-usb-xtal.kicad_sch]
2026-02-06 - Routed New boot pin properly, added test points to old spots as backups - Filled some floating ground planes with vias near I2C2 Buffer - Routed UART0 to new pins properly - Fixed SD card connector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
    [mram-and-spi.kicad_sch, oresat-c3-sch-connectors.kicad_sch, oresat-c3-sch-opd-and-i2c.kicad_sch, oresat-c3-sch-osd3358-power.kicad_sch, oresat-c3-sch-osd3358-sd-emmc.kicad_sch, oresat-c3-sch-osd3358-sip-e-f.kicad_sch, oresat-c3-sch-osd3358-sysboot.kicad_sch, oresat-c3-sch-osd3358-usb-xtal.kicad_sch]
2026-02-06 - Verified no copper pours - Verified the GPIO traces again - Labelled bottom of CSKB - Fixed Antenna on I2C2 Line (internal) - Went through DRC and fixed any real errors not related to footprints or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
2026-02-06 Added ground fencing via grid
2026-02-08 - Removed ground from mounting holes - Moves SLIP header lower so it doesnt go off edge of PCB
    [oresat-c3-sch-connectors.kicad_sch]
2026-02-08 moved around silkscreen
2026-02-16 added automotive grade capacitors to the BOM
    [mram-and-spi.kicad_sch, oresat-c3-sch-connectors.kicad_sch, oresat-c3-sch-opd-and-i2c.kicad_sch, oresat-c3-sch-osd3358-power.kicad_sch, oresat-c3-sch-osd3358-sd-emmc.kicad_sch, oresat-c3-sch-osd3358-sysboot.kicad_sch, oresat-c3-sch-osd3358-usb-xtal.kicad_sch]
2026-02-16 added automotive grade resistors to BOM
    [mram-and-spi.kicad_sch, oresat-c3-sch-connectors.kicad_sch, oresat-c3-sch-opd-and-i2c.kicad_sch, oresat-c3-sch-osd3358-power.kicad_sch, oresat-c3-sch-osd3358-sd-emmc.kicad_sch, oresat-c3-sch-osd3358-sysboot.kicad_sch, oresat-c3-sch-osd3358-usb-xtal.kicad_sch]
2026-02-16 modified BOM to match PCBWay format
    [mram-and-spi.kicad_sch, oresat-c3-sch-connectors.kicad_sch, oresat-c3-sch-opd-and-i2c.kicad_sch, oresat-c3-sch-osd3358-power.kicad_sch, oresat-c3-sch-osd3358-sd-emmc.kicad_sch, oresat-c3-sch-osd3358-sip-e-f.kicad_sch, oresat-c3-sch-osd3358-sysboot.kicad_sch, oresat-c3-sch-osd3358-usb-xtal.kicad_sch]
2026-02-16 finished putting together BOM, needs review
    [mram-and-spi.kicad_sch, oresat-c3-sch-connectors.kicad_sch, oresat-c3-sch-opd-and-i2c.kicad_sch, oresat-c3-sch-osd3358-power.kicad_sch, oresat-c3-sch-osd3358-sd-emmc.kicad_sch, oresat-c3-sch-osd3358-sip-e-f.kicad_sch, oresat-c3-sch-osd3358-sysboot.kicad_sch, oresat-c3-sch-osd3358-usb-xtal.kicad_sch]
2026-02-18 - Fixed part number for FRAM, CAN transceiver, emmc, and BJT - Change LED and connected resistors to DNP - Verified remainder of components
    [oresat-c3-sch-opd-and-i2c.kicad_sch, oresat-c3-sch-osd3358-power.kicad_sch, oresat-c3-sch-osd3358-sd-emmc.kicad_sch, oresat-c3-sch-osd3358-sysboot.kicad_sch]
2026-02-19 - Increased thermal relief size for Ground pads and some 3v3 pads - Made slight improvements to routing for I2C, UART lines - Uart 4 moved to not cross over power plane - Added stitching capacitor ne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
    [oresat-c3-sch-connectors.kicad_sch, oresat-c3-sch-osd3358-power.kicad_sch]
2026-02-19 - Adjusted some GND/3.3V thermal reliefs - Added teardrops for all trace connections to vias and pads - Placed few extra GND vias to better connect ground pours and prevent cross talk (SPI)
2026-02-21 moved SD card boot pin to the top of the board
2026-02-21 - removed C5 pin connected to GPIO4/A3 - Redid teardrops - fixed one DRC issue with a via
    [oresat-c3-sch-osd3358-sd-emmc.kicad_sch]
2026-02-22 Changed trace clearance to meet requirements for PCBWay 2 oz copper
2026-02-22 Fixed GPIO4 and increased trace widths, added stitching vias to reduce parasitic cap.
    [oresat-c3-sch-osd3358-sd-emmc.kicad_sch]
2026-02-22 Removed ground vias interfering with current traces
2026-02-22 - Fixed gpio4 again, C5 is the final correct pin, do not need to connect to A3 - fixed canBus net to be correct length - Fixed one DRC issue, remaining issues are not to be concerned with
    [oresat-c3-sch-osd3358-sd-emmc.kicad_sch]
2026-02-22 Updated board constraints
2026-02-22 Manually reverting KiCad files to state before ff5831f due to conflicts
    [oresat-c3-sch-osd3358-sd-emmc.kicad_sch]
2026-02-22 Restored GPIO 4 and re-fized canbus trace width
    [oresat-c3-sch-osd3358-sd-emmc.kicad_sch]
2026-02-24 - Modified trace width for I2C, UART to 0.25 mm - Might still modify the traces of UART4 that connect to the OSD
2026-02-25 Changed spi trace width to 0.25 mm
2026-02-26 Removed random edge cut line
2026-02-28 Fixed some BOM issues. Board has been ordered, generated production files
    [oresat-c3-sch-osd3358-power.kicad_sch, oresat-c3-sch-osd3358-sd-emmc.kicad_sch, oresat-c3-sch-osd3358-sip-e-f.kicad_sch, oresat-c3-sch-osd3358-sysboot.kicad_sch, oresat-c3-sch-osd3358-usb-xtal.kicad_sch, oresat-c3.kicad_pcb_bom.csv, oresat-c3.kicad_pcb_positions.csv]
2026-02-28 Created stp file of the board for the Mechanical team
2026-05-07 Adjusted silkscreen for easier assembly inspection
2026-05-08 Finished rerouting CAN
    [mram-and-spi.kicad_sch, oresat-c3-sch-connectors.kicad_sch, oresat-c3-sch-opd-and-i2c.kicad_sch, oresat-c3-sch-osd3358-power.kicad_sch, oresat-c3-sch-osd3358-sd-emmc.kicad_sch, oresat-c3-sch-osd3358-sip-e-f.kicad_sch, oresat-c3-sch-osd3358-sysboot.kicad_sch, oresat-c3-sch-osd3358-usb-xtal.kicad_sch]
2026-05-09 Fixed i2c teardrops
2026-05-09 Fixed DRC errors, created new BOM, submitted new order to PCBway
    [oresat-c3.kicad_pcb_bom.csv, oresat-c3.kicad_pcb_positions.csv]
